PeraZver/MP3-Player-Marko/Readme.md

# Marko MP3 Player

ATMEGA32U2 based MP3 player with SD card data storage, OLED display, optional VS1005 decoder, LiPo battery charger and audio buffer.
