PeraZver/MP3-Player-Marko/Doc/main.tex

\documentclass[]{report}

% Title Page
\title{Uređaj za reprodukciju glazbe za ugradnju u knjige.}
\author{Pero Krivi\'c}

\begin{document}
\maketitle

\begin{abstract}
	
	Ovo je dokumentacija projekta "MP3 player za ugradnju u knjige" za Marka Matijevića.
	
\end{abstract}

%\input{schematics.tex}

\end{document}
