PeraZver/MP3-Player-Marko/Doc/main.pdf

# Ureaj za reprodukciju glazbe za ugradnju u

knjige.

Pero Krivi´c

May 29, 2016

Abstract

Ovo je dokumentacija projekta ”MP3 player za ugradnju u knjige” za Marka Matijevia.
