PeraZver/MP3-Player-Marko/Doc/img/bottom.png

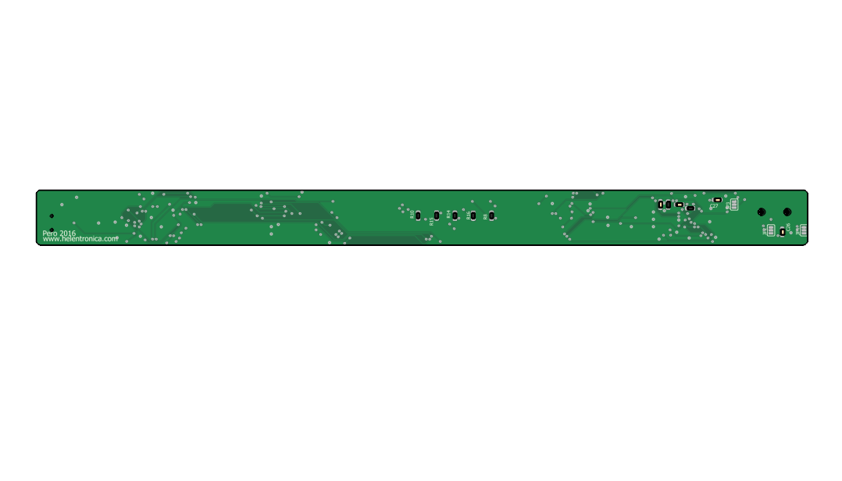
Doc/img/bottom.png
