PeraZver/MP3-Player-Marko/Doc/img/persp1.png

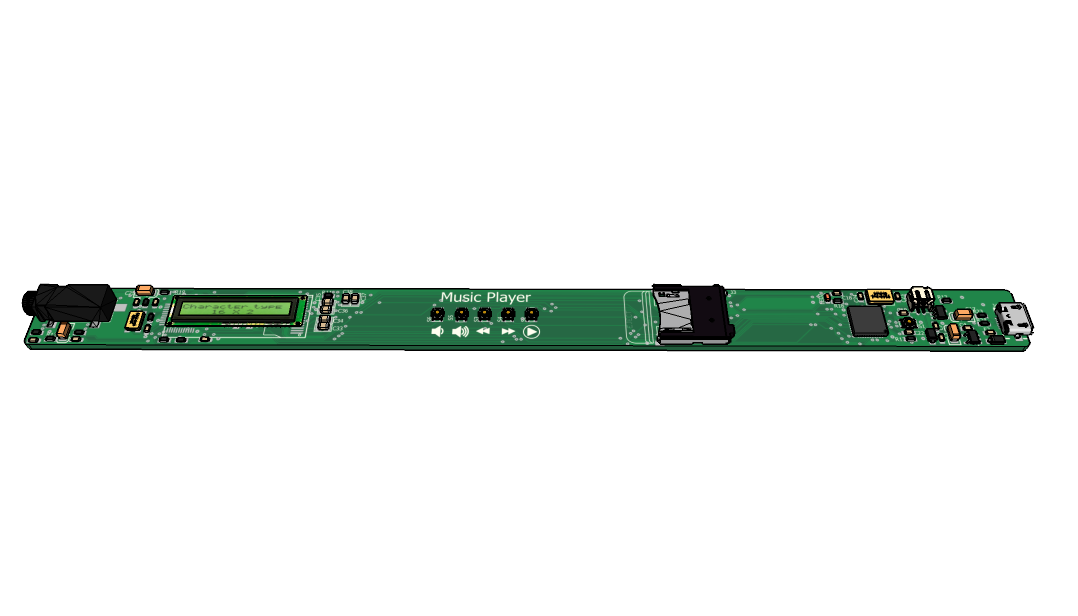
Doc/img/persp1.png
