PeraZver/MP3-Player-Marko/Doc/img/persp2.png

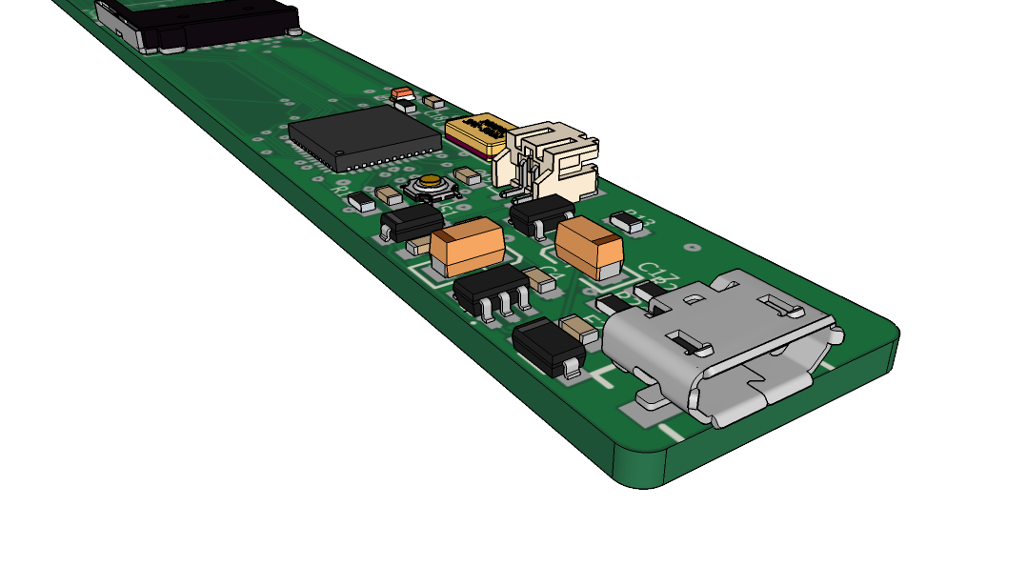
Doc/img/persp2.png
