PeraZver/MP3-Player-Marko/Doc/img/persp3.png

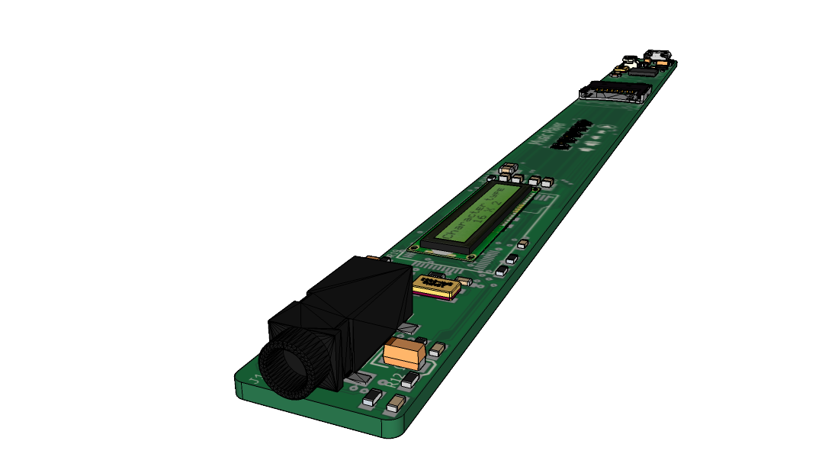
Doc/img/persp3.png
