PeraZver/MP3-Player-Marko/Doc/img/playl_ctrl.png

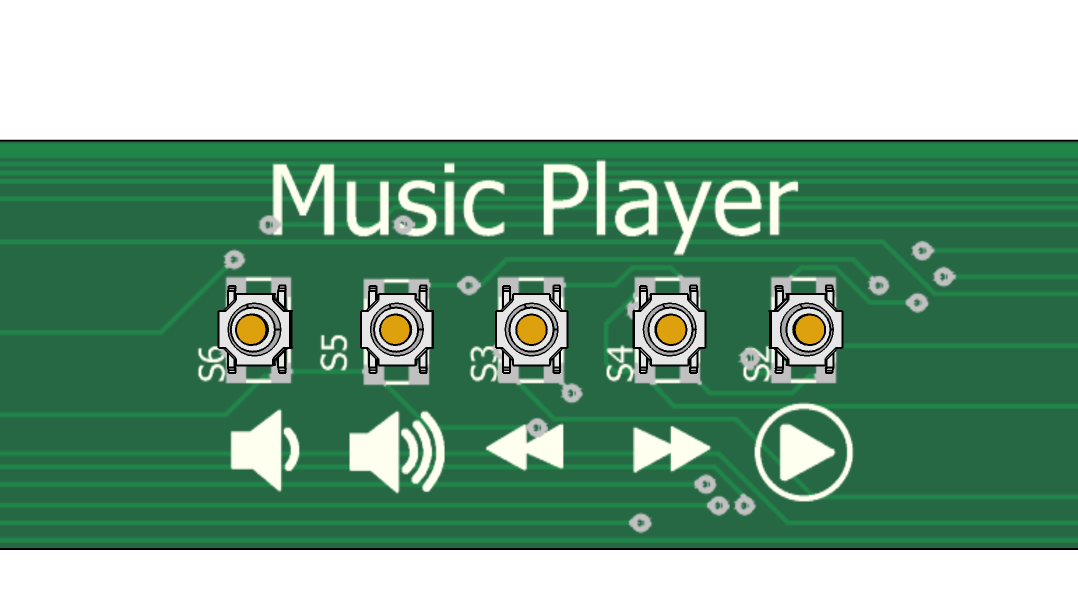
Doc/img/playl_ctrl.png
