PeraZver/MP3-Player-Marko/Doc/img/top.png

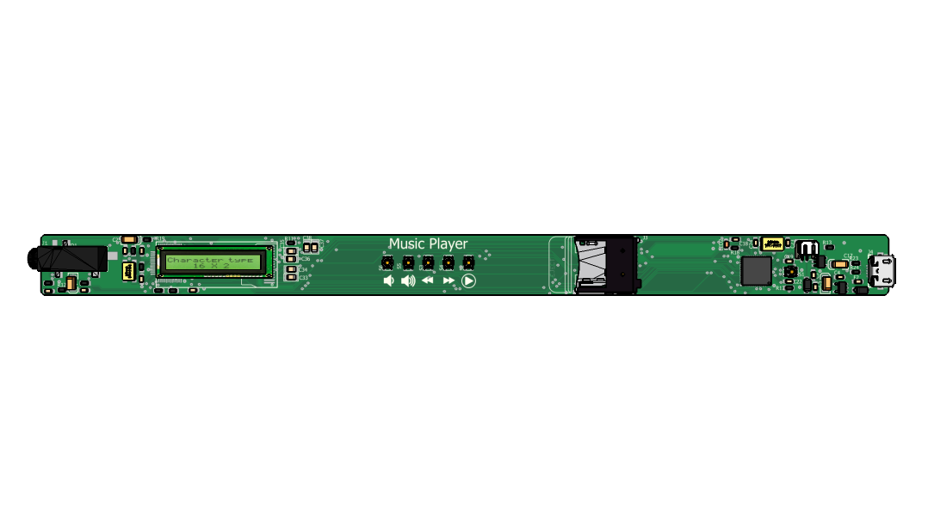
Doc/img/top.png
