PeraZver/MP3-Player-Marko/HW/eagleUp/eagleUp_MP3_Player_board_top.jpg

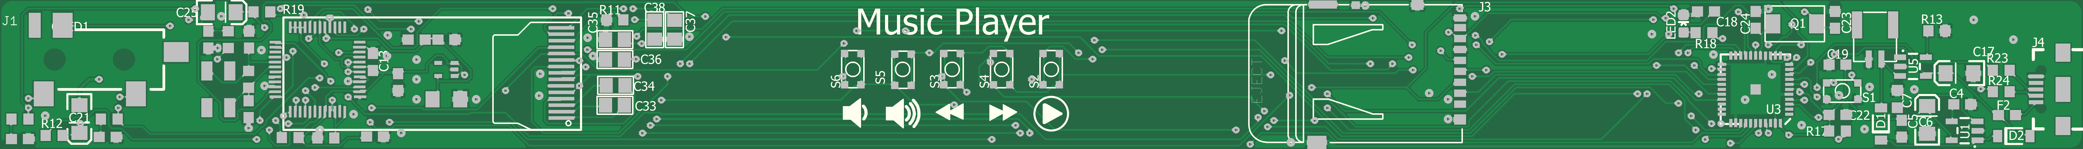
HW/eagleUp/eagleUp_MP3_Player_board_top.jpg
