PeraZver/MP3-Player-Marko/HW/MP3_Player.dxf

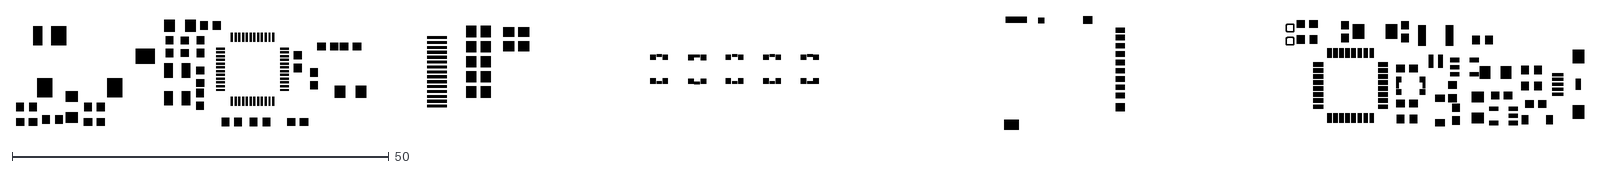
[picture p10: CAD file, 2016-09-01]
HW/MP3_Player.dxf
208.2 x 15.0
