PeraZver/MP3-Player-Marko/(list of files, cad)

Other CAD files:
Doc/3d/test2.skp
