PeraZver/MP3-Player-Marko/HW/No MP3 variant/Assembly-bottom.pdf

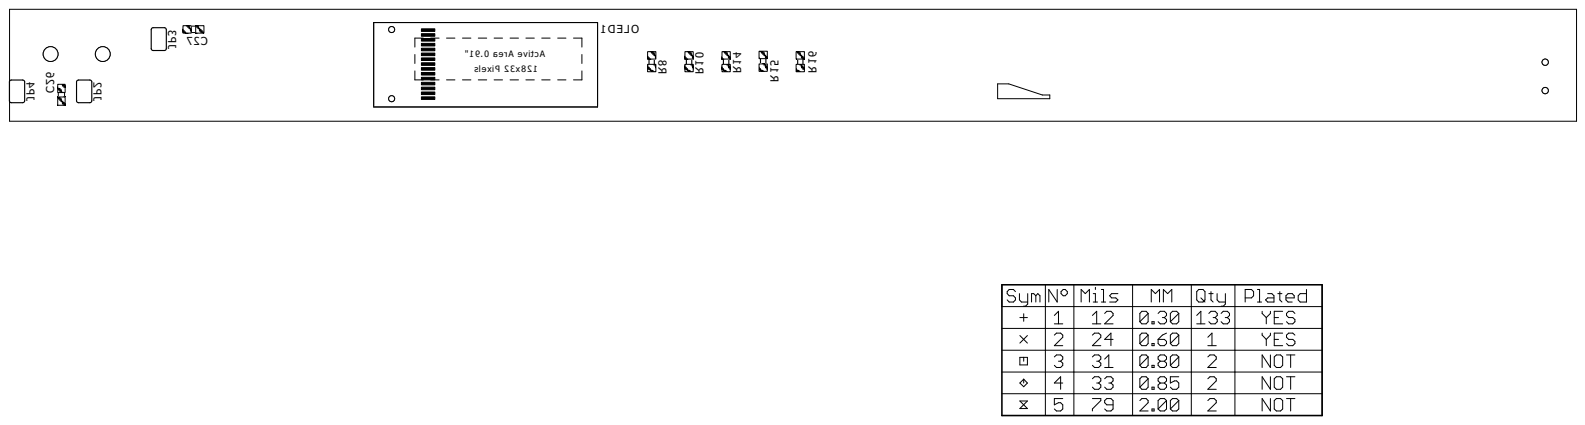
[picture p11: page 1]
