PeraZver/MP3-Player-Marko/HW/No MP3 variant/Assembly-top.pdf

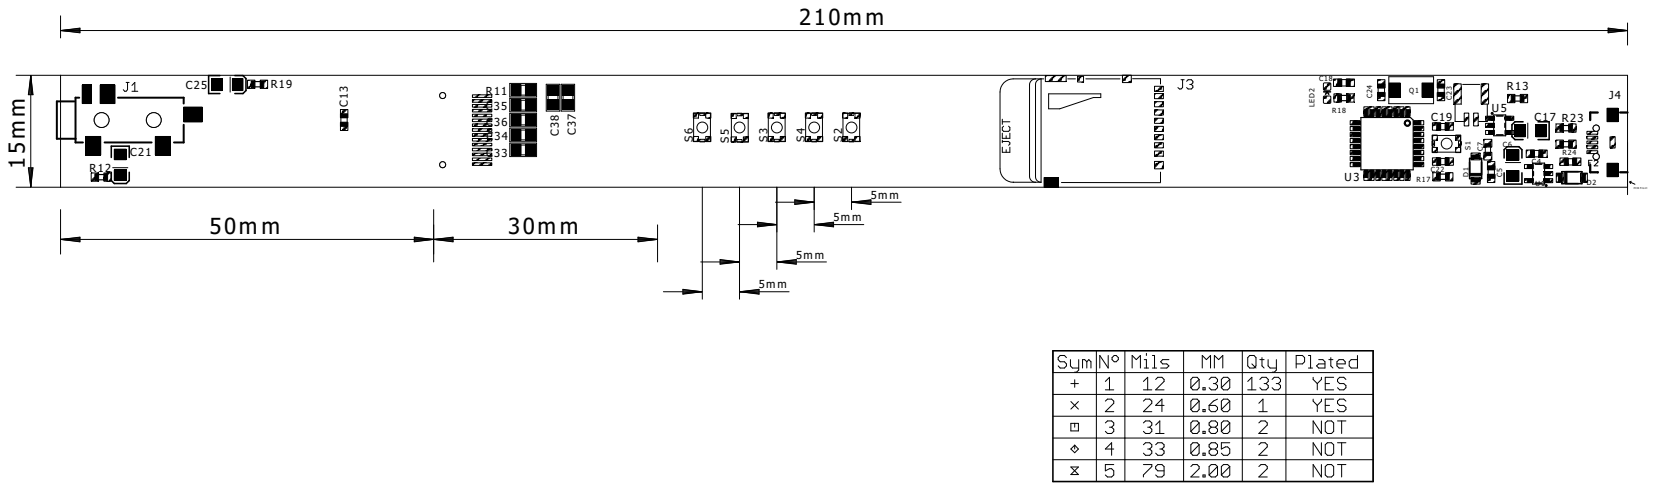
[picture p12: page 1]
