PeraZver/MP3-Player-Marko/HW/No MP3 variant/Schematics.pdf

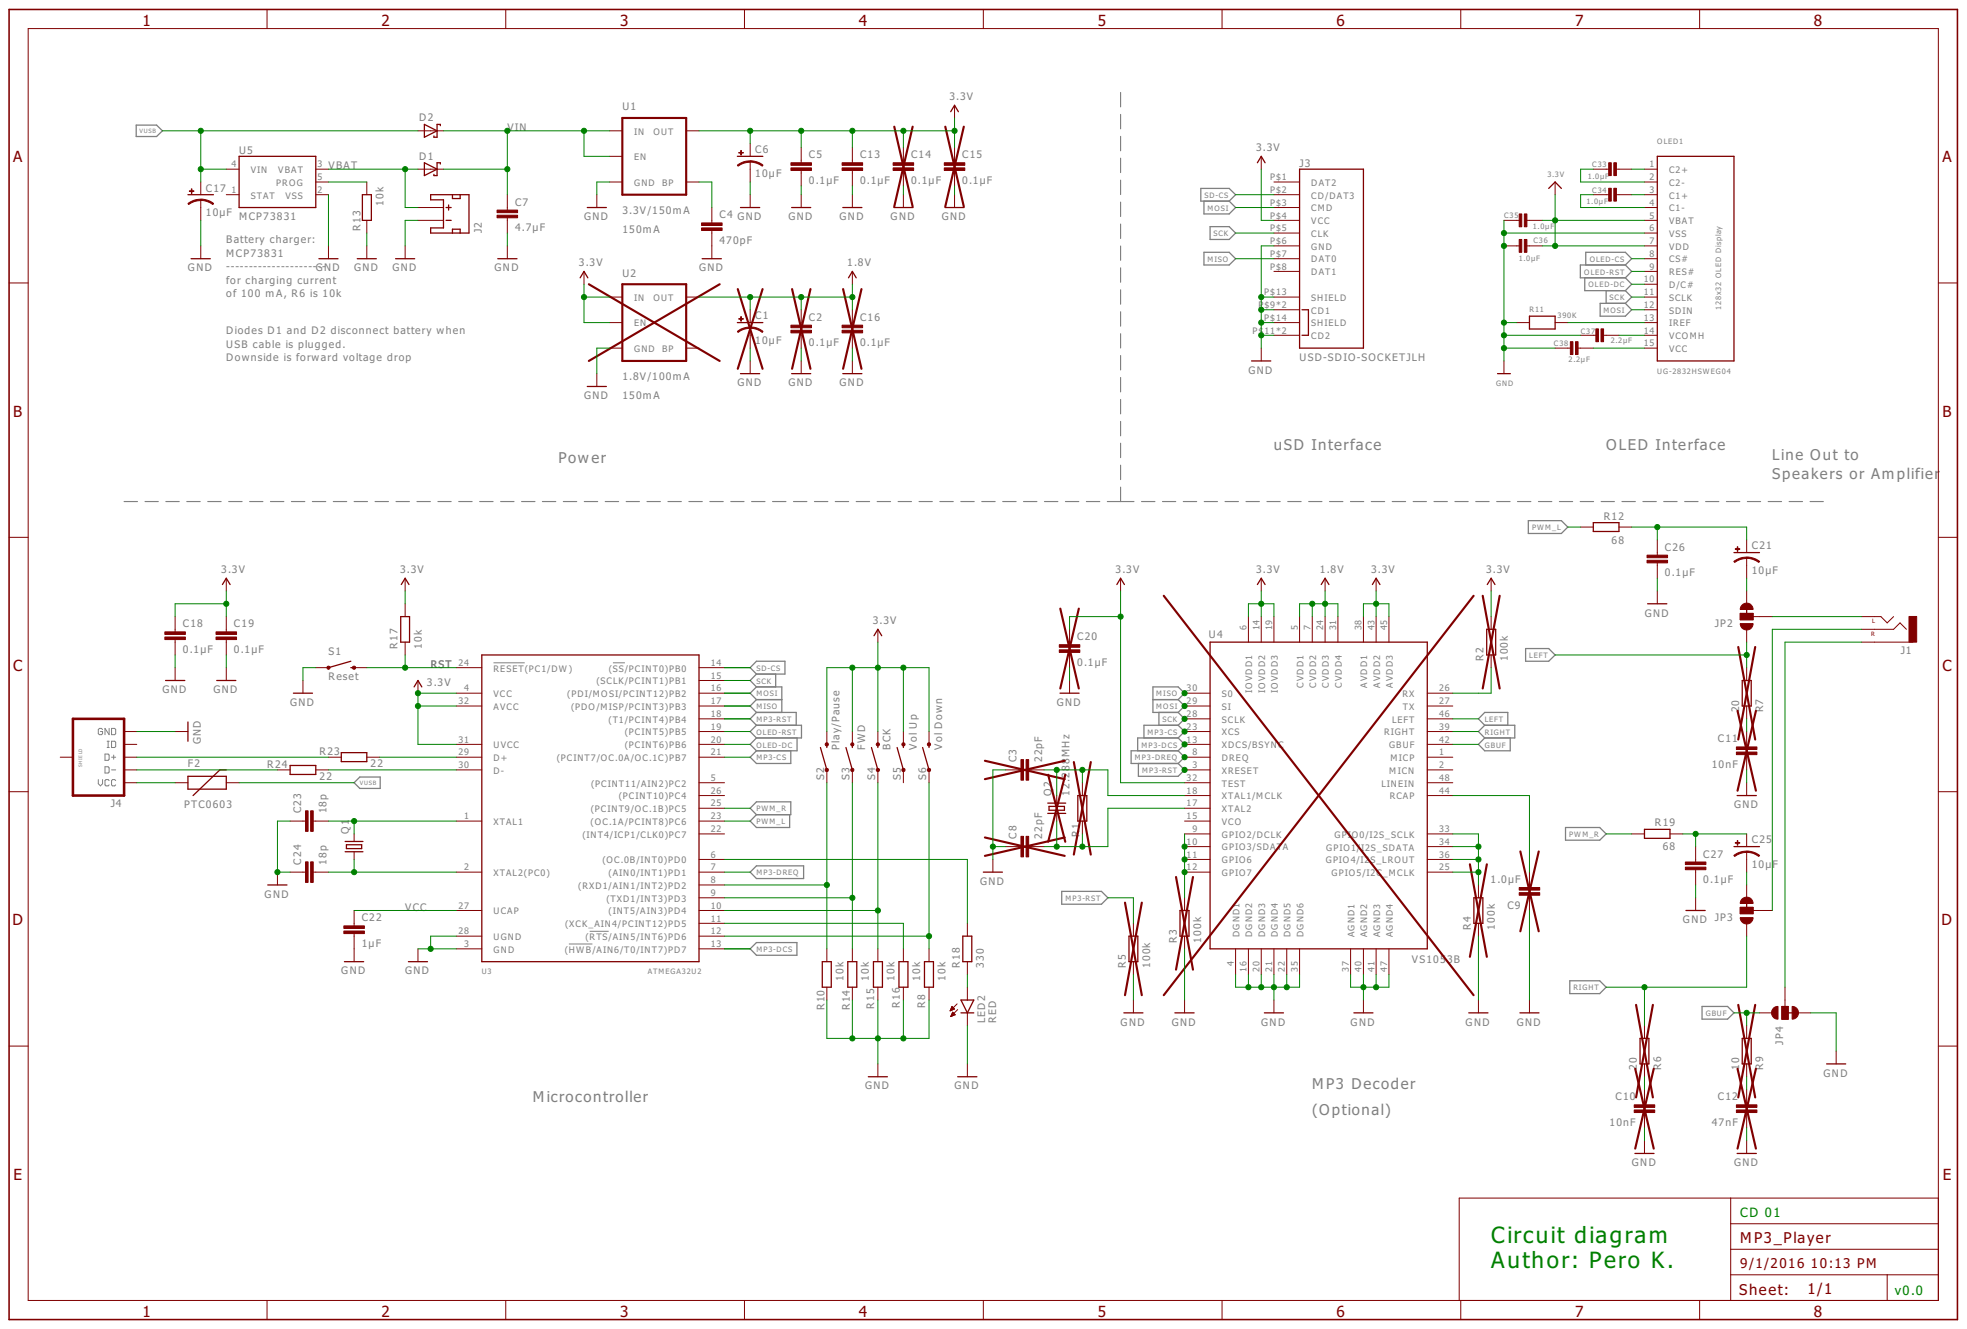
[picture p13: page 1]

OLED-CS OLED-RST

10
11
12

3 | 13 MP3-DCS
