PeraZver/MP3-Player-Marko/(commit log)

2016-05-29 Initial commit.
    [MP3_Player.brd, MP3_Player.sch]
2016-06-05 changed buttons, oscillator and JST connector
    [MP3_Player.brd, MP3_Player.sch]
2016-06-17 Changed uSD socket. Components placed
    [DRILEGEND.CFG, MP3_Player.brd, MP3_Player.sch]
2016-06-17 Comit before 1st autorouter
    [MP3_Player.brd]
2016-06-17 Micro USB instead of mini USB. Created "No MP3" variant. Audio jack verified.
    [MP3_Player.brd, MP3_Player.sch]
2016-06-21 added 3d model. new button.
    [MP3_Player.brd, MP3_Player.sch]
2016-06-28 Auto router not bad
    [MP3_Player.brd, MP3_Player.sch]
2016-07-02 completed routing, now just checking
    [MP3_Player.brd, test2.skp]
2016-07-02 Completed routing and verified. Added RC filters
    [MP3_Player.brd, MP3_Player.sch]
2016-07-02 gerber files generated
    [MP3_Player.brd]
2016-07-02 return to last commit
    [MP3_Player.brd]
2016-07-02 Revert "gerber files generated"
    This reverts commit 90f40b43d4a083a928ce2398cded0cba18803147.
2016-07-02 Revert "Revert "gerber files generated""
    This reverts commit 3da6fa17a727ae74702837ae0393dc95fa27751b.
2016-07-02 clear the mess
    [MP3_Player.brd]
2016-07-12 prettier schematics and BOM
    [MP3_Player.brd, MP3_Player.sch]
2016-09-01 assembly drawings
    [DRILEGEND.CFG, MP3_Player.brd, MP3_Player.dxf, MP3_Player.sch]
2016-09-03 fixing missing wire on schematics
    [MP3_Player.brd, MP3_Player.sch]
2016-09-27 Introduced to ATmega32u4 and redrew missing lines
    [MP3_Player.brd, MP3_Player.sch]
2016-09-27 changed OLED footprint
    [MP3_Player.brd, MP3_Player.sch]
2016-09-29 Autorouter dobar, al bez thermal pada
    [MP3_Player.brd, MP3_Player.sch]
2016-09-29 routing complete, no orphans
    [MP3_Player.brd]
2016-09-29 Autorouter finished
    [MP3_Player.brd, MP3_Player.sch]
2016-09-29 atmega routed
    [MP3_Player.brd]
2016-09-29 routed Oled
    [MP3_Player.brd]
2016-09-29 passed DRC
    [MP3_Player.brd]
2016-09-30 Silkscreen and music icons
    [MP3_Player.brd, MP3_Player.sch]
2016-09-30 Fixed silkscreen and ordered
    [MP3_Player.brd]
2016-12-10 First software version
    [MP3_Player.brd, MP3_Player.sch]
2016-12-11 Basic button functionality for all buttons
2016-12-11 Playlist doesn't stop when not-the-last song is over
    [Marko_WAV_Player.ino]
2016-12-18 button functionality with long names
2016-12-18 works with any SD card, but no OLED (too much memory
    [Marko_WAV_Player.ino]
2016-12-20 3D model and images
    [MP3_Player.brd, MP3_Player.sch]
